RJTK/SDR_capstone/README

Ryan J. Kinnear (C) 2014

Fourth year project.

The goal is to build a simple software defined radio peripheral.
