RJTK/SDR_capstone/model/ADC_driver/driver_to_ADC.spice

AD8138 to ADC model
* AD8138 SPICE Macro-model  
* Description: Amplifier
* Generic Desc: Low distortion diff I/O amp - 500 MHz
* Developed by: JG/ADI, TRW/ADI
* Revision History: 08/10/2012 - Updated to new header style
* 5.0 (11/2002)
* Copyright 1999, 2012 by Analog Devices, Inc.
*
* Refer to http://www.analog.com/Analog_Root/static/techSupport/designTools/spiceModels/license/spice_general.html for License Statement. Use of this model
* indicates your acceptance with the terms and provisions in the License Statement.
*
* BEGIN Notes:
*
* Not Modeled:
*     vnoise, not included in this version
*     inoise, not included in this version
*     distortion is not characterized
*     cmrr is not  characterized in this version.
*
* Parameters modeled include:
*     closed loop gain and phase vs bandwidth
*     output current and voltage limiting
*     offset voltage (is  non-static, will  vary with gain)
*     ibias (again, is static, will not vary with vcm)
*     slew rate and step response performance
*     (slew rate is based on 10-90% of step response)
*     current on output will be reflected to the supplies 
*     Vocm is variable and include input typical offset
*
* END Notes:
*
* Node assignments
*                non-inverting input
*                | inverting input
*                | | positive supply
*                | | |  negative supply
*                | | |  |  output positive
*                | | |  |  |   output negative
*                | | |  |  |   |   vocm input
*                | | |  |  |   |   |
.SUBCKT ad8138  3a 9 99 50 71b 71  110

****************************input stage*******************************************


*****positive input left side*****

I1 99 5 .4E-3
Q1 50 2 5 QX
vos 3a 2 -1.95E-3

**RAIL CLIPING****

DlimP 75 14b dx
VlimP 99 14b 2.1
Dlim 14c 75 dx
Vlim 14c  50 2.1
DlimN 13b 76 DX
VlimN 13b 50 2.1
Dlim_B 76 13C dx
Vlim_B 99 13C 2.1

** VOCM INPUT RAIL CLIPING****

DOCMa 100 100A dx
VOCMa 99 100A 1.899
DOCMb 100b 100 DX
VOCMb 100b 50 1.899

*****negative input right side*****

I2 99 6 .4E-3
Q2 50 9 6 QX

***********Input capacitance/impedance*******

Cin 3a 9 1p

***************************************pole, zero pole stage********************************************

G1 13 14 5 6 5e-3
c1 14 13 1.7p
c2 13 98 .6p
c3 14 98 .6p
r11 13 98 250k
r12 14 98 250k

*********pole zero stage( POSITIVE SIDE)*******

gp1 0 75 14 98 1
RP1 75 0 1
CP1 75 0 .38E-9

*********pole zero stage( NEGATIVE SIDE)*******

gp2 0 76 13 98 1
RP2 76 0 1
CP2 76 0 .38E-9

**********output stage Negative side*************

D17 76 84 DX
VO1  84 70 .177V
VO2  70 85 .177V
D16 85 76  DX
G30 70 99c 99 76  91E-3
G31 98c 70 76 50  91E-3
RO30 70 99c 11
RO31 98c 70 11
VIOUT1 99 99c 0V
VIOUT2 50 98c 0V
VIOUT3 70 71 0V

********** Output Stage Positive side *************

D17b 75 84b DX
VO1b  84b 70b .177V
VO2b  70b 85b .177V
D16b 85b 75  DX
G30b 70b 99d 99 75  91E-3
G31b 98d 70b 75 50  91E-3
RO30b 70b 99d 11
RO31b 98d 70b 11
VIOUTB1 99 99d 0V
VIOUTB2 98d 50 0V
VIOUTB3 70b 71b 0V

*********VOCM STAGE*************************

Gocm_a 0 75 110 0 1
Gocm_b 0 76 110 0 1
Rocm1 99 100 400k
Rocm2 100 50 400k
Voffset 100 110 -1E-3

********CURRENT MIRROR TO SUPPLIES POSITVIE SIDE*********

FO1 0 99 poly(2) VIOUT1 VI1 -19.803E-3 1 -1
FO2 0 50 poly(2) VIOUT2 VI2 -19.803E-3 1 -1
FO3 0 400 VIOUT1 1
VI1 401 0 0
VI2 0 402 0
DM1 400 401 DX
DM2 402 400 DX 

********CURRENT MIRROR TO SUPPLIES NEGATIVE SIDE*********

FO1B 0 99 poly(2) VIOUTB1 VIB1 -19.803E-3 1 -1
FO2B 0 50 poly(2) VIOUTB2 VIB2 -19.803E-3 1 -1
FO3B 0 400B VIOUTB1 1
VIB1 401B 0 0
VIB2 0 402B 0
DMB1 400B 401B DX
DMB2 402B 400B DX 

***  Reference Stage

Eref 98 0 poly(2) 99 0 50 0 0 0.5 0.5

.MODEL QX PNP (BF=228.57 Is=1E-15)
.MODEL DX D(IS=1E-15)
.ENDS

************************BANDSTOP FILTER****************************

* Bandstop filter, Order 5
* Node assignments
*                        Positive Input
*                        |   Negative Input
*                        |   |   Positive Output
*                        |   |   |    Negative Output
*                        |   |   |    |
.SUBCKT bandstop_filter5 inP inN outP outN

L1 inP N1 180n
L2 inP N2P 2700n
L3 N2P N2 120n
L4 N2P outP 2700n
L5 outP N3 150n
L6 inP N2N 2700n
L7 N2N outN 2700n

C1 N1 inN 2200p
C2 inN N2N 150p
C3 N2 N2N 3300p
C4 N2N outN 150p
C5 N3 outN 2200p
C6 inP N2P 150p
C7 N2P outP 150p

.ENDS

************************BANDSTOP FILTER****************************

* Bandstop filter, Order 3
* Node assignments
*                        Positive Input
*                        |   Negative Input
*                        |   |   Positive Output
*                        |   |   |    Negative Output
*                        |   |   |    |
.SUBCKT bandstop_filter3 inP inN outP outN

L1 inP N1 395n
L2 inP outP 6969n
L3 outP N2 395n
L4 inN outN 6960n

C1 inN N1 2784p
C2 inP outP 158p
C3 outN N2 2784p
C4 inN outN 158p

.ENDS

************************LOWPASS FILTER****************************

* lowpass filter, Order 5
* Node assignments
*                       Positive Input
*                       |   Negative Input
*                       |   |   Positive Output
*                       |   |   |    Negative Output
*                       |   |   |    |
.SUBCKT lowpass_filter5 inP inN outP outN

L1 inP N2P 130n
L2 N2P outP 130n
L3 inN N2N 130n
L4 N2N outN 130n

C1 inP inN 120p
C2 N2P N2N 180p
C3 outP outN 120p

.ENDS

************************LOWPASS FILTER****************************

* lowpass filter, Order 3
* Node assignments
*                       Positive Input
*                       |   Negative Input
*                       |   |   Positive Output
*                       |   |   |    Negative Output
*                       |   |   |    |
.SUBCKT lowpass_filter3 inP inN outP outN

L1 inP outP 112n
L2 inN outN 112n
C1 inP inN 45p
C2 outP outN 45p

.ENDS

************************BANDPASS FILTER****************************
**THERE IS SOMETHING BUGGY HERE
**REVISE LATER, NO IDEA WHAT THE PROBLEM IS

* bandpass filter, Order 3
* Node assignments
*                        Positive Input
*                        |   Negative Input
*                        |   |   Positive Output
*                        |   |   |    Negative Output
*                        |   |   |    |
.SUBCKT bandpass_filter3 inP inN outP outN

L1 inP inN 158n
L2 inP N2P 330n
L3 outP outN 158n
L4 inN N2N 330n

C1 inP inN 132p
C2 N2P outP 63p
C3 outP outN 132p
C4 N2N outN 63p

.ENDS

************************UNITY GAIN OP AMP****************************

* unity gain differential op amp
* Node assignments
*                       Positive Input
*                       |   Negative Input
*                       |   |   Positive Output
*                       |   |   |    Negative Output
*                       |   |   |    |    Common mode voltage
*                       |   |   |    |    |
.SUBCKT unity_gain_amp inP inN outP outN Vocm

Xad8138 op_inP op_inN PSUP NSUP outP outN Vocm ad8138

**INPUT RESISTORS**
RgP inP op_inP 500
RgN inN op_inN 500

**FEEDBACK RESISTORS**
RfN outN op_inP 500
RfP outP op_inN 500
CfN outN op_inP 1p
CfP outP op_inN 1p

**POWER SUPPLY**
Vpsup PSUP 0 dc 5
Vnsup NSUP 0 dc -5

.ENDS

* ADC pin model
* Node assignments
*          
*               Input
*               |  Output
*               |  |
.SUBCKT ADC_pin in out

Cpkg in 0 .65p
Rpkg in N1 .04
Lpkg N1 out .65n
Cin out 0 7p
Rin out 0 7K

.ENDS

************************MAIN CIRCUIT****************************

Xamp inP inN amp_outP amp_outN Vocm unity_gain_amp
*RL amp_outP amp_outN 100
RLP amp_outP load_outP 0
RLN amp_outN load_outN 0

** GOOD RESISTOR VALUES **
* no filters: RL = 100, RLP & RLN = 120
* lpf only: RL = 3, RLP & RLN = 25
* Both filters: RL = 3, RLP & RLN = 25
* Using both filters is significantly worse

*Xbsf load_outP load_outN filt1_outP filt1_outN bandstop_filter3
*Xlpf filt1_outP filt1_outN filt_outP filt_outN lowpass_filter3

XpinP load_outP outP ADC_pin
XpinN load_outN outN ADC_pin

************************INPUTS****************************
Vocm Vocm 0 dc 1.5

**40MEG 2Vpp SINUSOID**
*VtestP inP 0 dc 0 SIN(0 1 40MEG)
*VtestN inN 0 dc 0 SIN(0 1 40MEG 0 0 -180)

**STEP RESPONSE**
*VtestP inP 0 dc 0 PULSE(0 1 2ns .1ns 1ns 1us 0)
*VtestN inN 0 dc 0 PULSE(0 -1 2ns .1ns 1ns 1us 0)

**IMPULSE RESPONSE**
*VtestP inP 0 dc 0 PULSE(0 1 2ns .1ns .1ns .1ns 0)
*VtestN inN 0 dc 0 PULSE(0 -1 2ns .1ns .1ns .1ns 0)

**FM MODULATED**
*Pretty sure this isn't really working*
*VtestP inP 0 dc 0 SFFM(0 1 36MEG 7500 10KHz)
*VtestN inN 0 dc 0 SFFM(0 -1 36MEG 7500 10KHz)

**AC ANALYSIS**
Vtest in 0 dc 0 ac 1
EtestP inP 0 in 0 1
EtestN inN 0 in 0 -1

************************PLOTS AND SIMULATIONS****************************

.control
ac dec 10 1MEG 500MEG
plot vdb(outP) xlog
*plot phase(outP)

*tran .01ns 50ns
*plot inP inN
*plot outP outN
.endc

.end
