RJTK/SDR_capstone/schem/fourth_year/filter_test.sch

## KiCad design schem/fourth_year/filter_test.sch (2014-12-07)

Schematic: filter_test.sch

Parts:
C1, C4: 390pF
C2, C3: 20pF
K1, K2, K3, K4: CONN_3
L1: 470uH; manu_part# B82462G4474M; digikey_part# 495-5662-1-ND
L2, L4, L5: 470uH
L3, L8: 51nH
L6, L7: 1000nH
P1: CONN_1_FEMALE
P2, P14: BNC
P7: SAW
P12, P13: CONN_1_MALE
R1, R2, R3, R6, R7, R8, R9, R12, R15, R16, R17, R18: open
R4, R5, R10, R11, R13, R14, R19, R20, R21, R22: short
T1, T2: TRANSFO4
