RJTK/SDR_capstone/schem/fourth_year/fourth_year.sch

## KiCad design schem/fourth_year/fourth_year.sch (2015-01-22)

Schematic: fourth_year.sch

Parts:
C1, C2, C4, C7, C11, C12, C14, C15, C17, C20, C22: 1nF; 2.00mm x 1.25mm
C3: OPEN; 2.00mm x 1.25mm
C5, C39: 3pF; 2.00mm x 1.25mm
C6: 10uF
C8: .1uF
C9: 0.47uF; 3.20mm x 1.60mm
C10, C52, C53: 3uF
C13: 1.5nF; 2.00mm x 1.25mm
C16: 33nF; 1.25mm x 2.00mm WIDE
C18, C19: 26pF; 2.00mm x 1.25mm
C21: 18pF; 1.00mm x 0.55mm
C23: 1uF; 2.30mm x 1.60mm
C24, C25: 10nF; 2.00mm x 1.25mm
C26, C29: 150uF
C27, C28: 3uF; 3.20mm x 2.50mm
C30: 10uF, 1ohm ESR; 3.20mm x 1.60mm
C31, C36, C45: 10uF; 2.00mm x 1.25mm
C32, C33, C34, C35, C37, C38, C47, C48: .1uF; 3.20mm x 1.60mm
C40, C41: 1uF; 3.20mmX1.60mm
C42: 22uF
C43, C44: 45pF; 1.60mm x 0.80mm
C46: 82pF; 3.20mm x 1.60mm
C49, C57, C58, C59, C60, C61: 47uF
C50: 1uF; 3.20mm x 1.60mm
C51: 100uF
C54, C55, C56: 1uF
D1: 1N5817; THROUGH HOLE
L1, L7: OPEN
L2: 47nH; 1.60mm x 0.80mm
L3: 270nH; 1.60mm x 0.80mm
L4: 68nH; 1.60mm x 0.80mm
L5: 15nH; 1.60mm x 0.80mm
L6: 19nH; 1.19mm x 0.64mm
L9: 150nH; 1.60mm x 0.80mm
L10, L12: FERRITE BEAD; 1.00mm x 0.50mm
L18, L19: 112nH; 1.60mm x 0.80mm
L20: OPEN; 3.20mm x 1.60mm
L21: 10uH; 3.20mm x 1.60mm
L22: 22uH; 3.20mm x 1.60mm
P1: F Type; F TYPE CONN
P2: SAW
P3, P5, P11, P12: CONNECTOR; FEMALE CONN THROUGH HOLE
P4: DC JACK; JACK
P6, P9: CONN_6; THROUGH HOLE CONN
P7, P8: BNC
P10: BNC
Q1: LT1086
Q2: UA78L05
R2: 560; 3.20mm x 1.60mm
R3: OPEN / 360; 2.00mm x 1.25mm
R4: 100/OPEN; 3.20mm x 1.60mm
R5, R6, R9, R10, R13: 10K; 3.20mm x 1.60mm
R7, R8, R11, R12: 500; 3.20mm x 1.60mm
R14: 20K; 3.20mm x 1.60mm
R16, R17: 120/SHORT; 3.20mm x 1.60mm
T1: TRANSFO4
U1: MAX3543
U2: AD8138
U3: TPS7330QP
U4: AD9235; THROUGH HOLE CONN
U5: FMC_LPC
U6, U7: 74VHC541FT
U8: TPS6735
X1: CRYSTAL

Notes on the sheet:
Female Conn. To BBB.
For DC blocking
PLL Charge Pump
Clapp Oscillator
Diplex Filter
No idea what this is for
RF TAP?
Function Generator Inputs
Matching Inductor
2v5
LINE DRIVERS
CLK
50 OHM LINES
75 OHM LINES
SEE SPICE MODEL & GENESYS
AA and Noise Supression Filter
120 ohm
100 ohm
The high frequency side has been eliminated
POWER STAR ROOT FOR MAX3543
I've put the + signal into the - input for board routing convenience.
ADD SCHMITT TRIGGER
