RJTK/SDR_capstone/(commit log)

2014-09-23 Started model for FM radio mod/demod
    [fourth_year.sch, frontend.sch]
2014-10-16 Bandpass limiter switch
2014-11-24 filter test PCB mostly completed
    [filter_test.brd, filter_test.csv, filter_test.sch, fourth_year.sch]
2014-12-07 Added ADC to model, updated schematic, created test data generator
    [filter_test.brd, filter_test.sch, fourth_year.sch]
2014-12-22 Minor schem modifications, started final report
    [fourth_year.sch]
2014-12-27 Created fmc_lpc pad (see make_fmc_pads.py). Broke up model src files.
    [fourth_year.brd, fourth_year.sch]
2014-12-29 Some minor schematic work
    [fourth_year.sch]
2015-01-01 Minor schematic updates
    [filter_test.csv, fourth_year.sch]
2015-01-05 Schematic complete. Started work on pcb layout
    [fourth_year.brd, fourth_year.sch]
2015-01-05 minor file updates
    [fourth_year.sch]
2015-01-05 Eliminated UHF input
    [fourth_year.sch]
2015-01-06 Progress on main PCB
    [fourth_year.brd, fourth_year.csv, fourth_year.sch]
2015-01-06 More work on PCB
    [fourth_year.brd]
2015-01-07 Router power
    [fourth_year.brd, fourth_year.sch]
2015-01-07 Minor changes
    [fourth_year.brd]
2015-01-08 More PCB work
    [fourth_year.brd, fourth_year.sch]
2015-01-10 Started routing ADC
    [fourth_year.brd, fourth_year.csv, fourth_year.sch]
2015-01-10 Routed line drivers
    [fourth_year.brd, fourth_year.csv, fourth_year.sch]
2015-01-10 Minor update
    [fourth_year.brd]
2015-01-14 Completed ENEL417 prelim document, also minor PCB updates
    [fourth_year.brd]
2015-01-17 PCB routing done. Doing some optimization and copper fills
    [fourth_year.brd, fourth_year.sch]
2015-01-17 Polishing PCB layout. Ground planes, copper pours, vias etc... Checking correctness
    [fourth_year.brd, fourth_year.sch]
2015-01-19 Some polish on PCB, from yesterday...
    [fourth_year.brd]
2015-01-22 PCB finalized, order has been placed
    [fourth_year.brd, fourth_year.sch]
2015-01-25 Some work on final report
    [fourth_year.brd]
2015-02-06 PCB corrections, changed to REV2
    [fourth_year.brd]
2015-02-16 Additions to final report
    [fourth_year.brd]
2015-02-19 Branches would probably have been wise.
    [fourth_year.kicad_pcb]
2015-02-21 Developed and tested FPGA PWM audio module
